scu-pnt/receiver-v0/max2769test.csv

Reference | Qty | Value | DNP | Exclude from BOM | Exclude from Board | Footprint | Datasheet
C1,C2 | 2 | .47n |  |  |  | Capacitor_SMD:C_0402_1005Metric
C3 | 1 | 27p |  |  |  | Capacitor_SMD:C_0603_1608Metric
C4 | 1 | .47n |  |  |  | Capacitor_SMD:C_0603_1608Metric
C6,C7,C8,C9,C28,C29,C51,C52,C62,C63 | 10 | 1u |  |  |  | Capacitor_SMD:C_0603_1608Metric
C10,C12,C14,C16,C18 | 5 | 100p |  |  |  | Capacitor_SMD:C_0402_1005Metric
C11,C13,C15,C17,C19,C31,C33,C35,C37,C39,C42,C44,C46,C48,C50,C54,C56,C66 | 18 | 100n |  |  |  | Capacitor_SMD:C_0402_1005Metric
C20,C22,C57,C64 | 4 | 100p |  |  |  | Capacitor_SMD:C_0603_1608Metric
C21,C23,C26,C61 | 4 | 100n |  |  |  | Capacitor_SMD:C_0603_1608Metric
C24 | 1 | .01u |  |  |  | Capacitor_SMD:C_0402_1005Metric
C25,C60 | 2 | 4.7u |  |  |  | Capacitor_SMD:C_0603_1608Metric
C27 | 1 | .1u |  |  |  | Capacitor_SMD:C_0603_1608Metric
C30,C32,C34,C36,C38,C41,C43,C53,C55,C65 | 10 | 4.7u |  |  |  | Capacitor_SMD:C_0402_1005Metric
C40 | 1 | 1u |  |  |  | Capacitor_SMD:C_0402_1005Metric
C58,C59 | 2 | 27p |  |  |  | Capacitor_SMD:C_0402_1005Metric
D1,D2,D3 | 3 | LED |  |  |  | LED_SMD:LED_0805_2012Metric
J1 | 1 | Conn_Coaxial |  |  |  | Connector_Coaxial:SMA_Samtec_SMA-J-P-H-ST-EM1_EdgeMount
J2 | 1 | RJ45_JK0654219 |  |  |  | Connector_RJ:RJ45_Pulse_JK0654219NL_Horizontal | https://media.digikey.com/pdf/Data%20Sheets/Pulse%20PDFs/JK%20Series.pdf
J3 | 1 | Conn_01x03_Socket |  |  |  | Connector_JST:JST_SH_SM03B-SRSS-TB_1x03-1MP_P1.00mm_Horizontal
J4 | 1 | Conn_01x05_Pin |  |  |  | Connector_PinHeader_2.54mm:PinHeader_1x05_P2.54mm_Vertical
J5 | 1 | USB_C_Receptacle_PowerOnly_6P |  |  |  | Connector_USB:USB_C_Receptacle_GCT_USB4125-xx-x_6P_TopMnt_Horizontal | https://www.usb.org/sites/default/files/documents/usb_type-c.zip
J6 | 1 | Conn_02x02_Odd_Even |  |  |  | Connector_PinHeader_2.54mm:PinHeader_2x02_P2.54mm_Vertical
JP3 | 1 | Jumper_2_Open |  |  |  | Connector_PinHeader_2.54mm:PinHeader_1x02_P2.54mm_Vertical
R1 | 1 | 20k |  |  |  | Resistor_SMD:R_0603_1608Metric
R2 | 1 | 22 |  |  |  | Resistor_SMD:R_0603_1608Metric
R3 | 1 | 100 |  |  |  | Resistor_SMD:R_0402_1005Metric
R4,R5,R6,R8,R10,R12,R32,R33,R34,R35,R36,R37,R38,R42 | 14 | 4.7k |  |  |  | Resistor_SMD:R_0603_1608Metric
R7 | 1 | 1.5k |  |  |  | Resistor_SMD:R_0603_1608Metric
R9,R11,R13 | 3 | 510 |  |  |  | Resistor_SMD:R_0603_1608Metric
R14,R15,R16,R17,R18,R19,R20,R21,R22,R23,R24,R25,R26,R27,R29,R30,R45 | 17 | 22 |  |  |  | Resistor_SMD:R_0402_1005Metric
R31 | 1 | 2.49k 1% |  |  |  | Resistor_SMD:R_0603_1608Metric
R39,R40,R41 | 3 | 10k |  |  |  | Resistor_SMD:R_0603_1608Metric
R43,R44 | 2 | 5.1k |  |  |  | Resistor_SMD:R_0603_1608Metric
SW1 | 1 | SW_Push |  |  |  | Button_Switch_THT:SW_PUSH_6mm
TP1,TP2,TP3,TP4,TP5,TP6,TP7,TP8,TP9,TP10,TP11,TP12,TP13,TP14,TP15,TP16,TP17,TP18,TP19,TP20,TP21,TP22,TP23,TP24,TP26,TP27,TP28,TP29,TP30,TP31,TP32,TP33,TP34,TP35 | 34 | TestPoint |  |  |  | TestPoint:TestPoint_Pad_D1.0mm
U1 | 1 | MAX2769B |  |  |  | Package_DFN_QFN:TQFN-28-1EP_5x5mm_P0.5mm_EP3.25x3.25mm_ThermalVias
U2 | 1 | ICE40UP5K-SG48ITR |  |  |  | Package_DFN_QFN:QFN-48-1EP_7x7mm_P0.5mm_EP5.6x5.6mm_ThermalVias | http://www.latticesemi.com/Products/FPGAandCPLD/iCE40Ultra
U3 | 1 | STM32C051K6T6 |  |  |  | Package_QFP:LQFP-32_7x7mm_P0.8mm | https://www.st.com/resource/en/datasheet/stm32c051c6.pdf
U4,U5,U7,U9 | 4 | TPS7A20 |  |  |  | Package_TO_SOT_SMD:SOT-23-5
U6 | 1 | TX22-M010S |  |  |  | Crystal:Crystal_SMD_WE_CFPX-218-4Pin_2.5x2.0mm
U8 | 1 | RTL8211FD |  |  |  | Package_DFN_QFN:QFN-40-1EP_5x5mm_P0.4mm_EP3.6x3.6mm_ThermalVias
U10,U11 | 2 | TPS22918 |  |  |  | Package_TO_SOT_SMD:SOT-23-6
U12 | 1 | BY25Q16AW |  |  |  | Package_SO:SOIC-8_3.9x4.9mm_P1.27mm
Y1 | 1 | TSX-3225 |  |  |  | Crystal:Crystal_SMD_3225-4Pin_3.2x2.5mm
