scu-pnt/receiver-v0/max2769test.kicad_pcb

## KiCad design max2769test.kicad_pcb (2026-11-08)

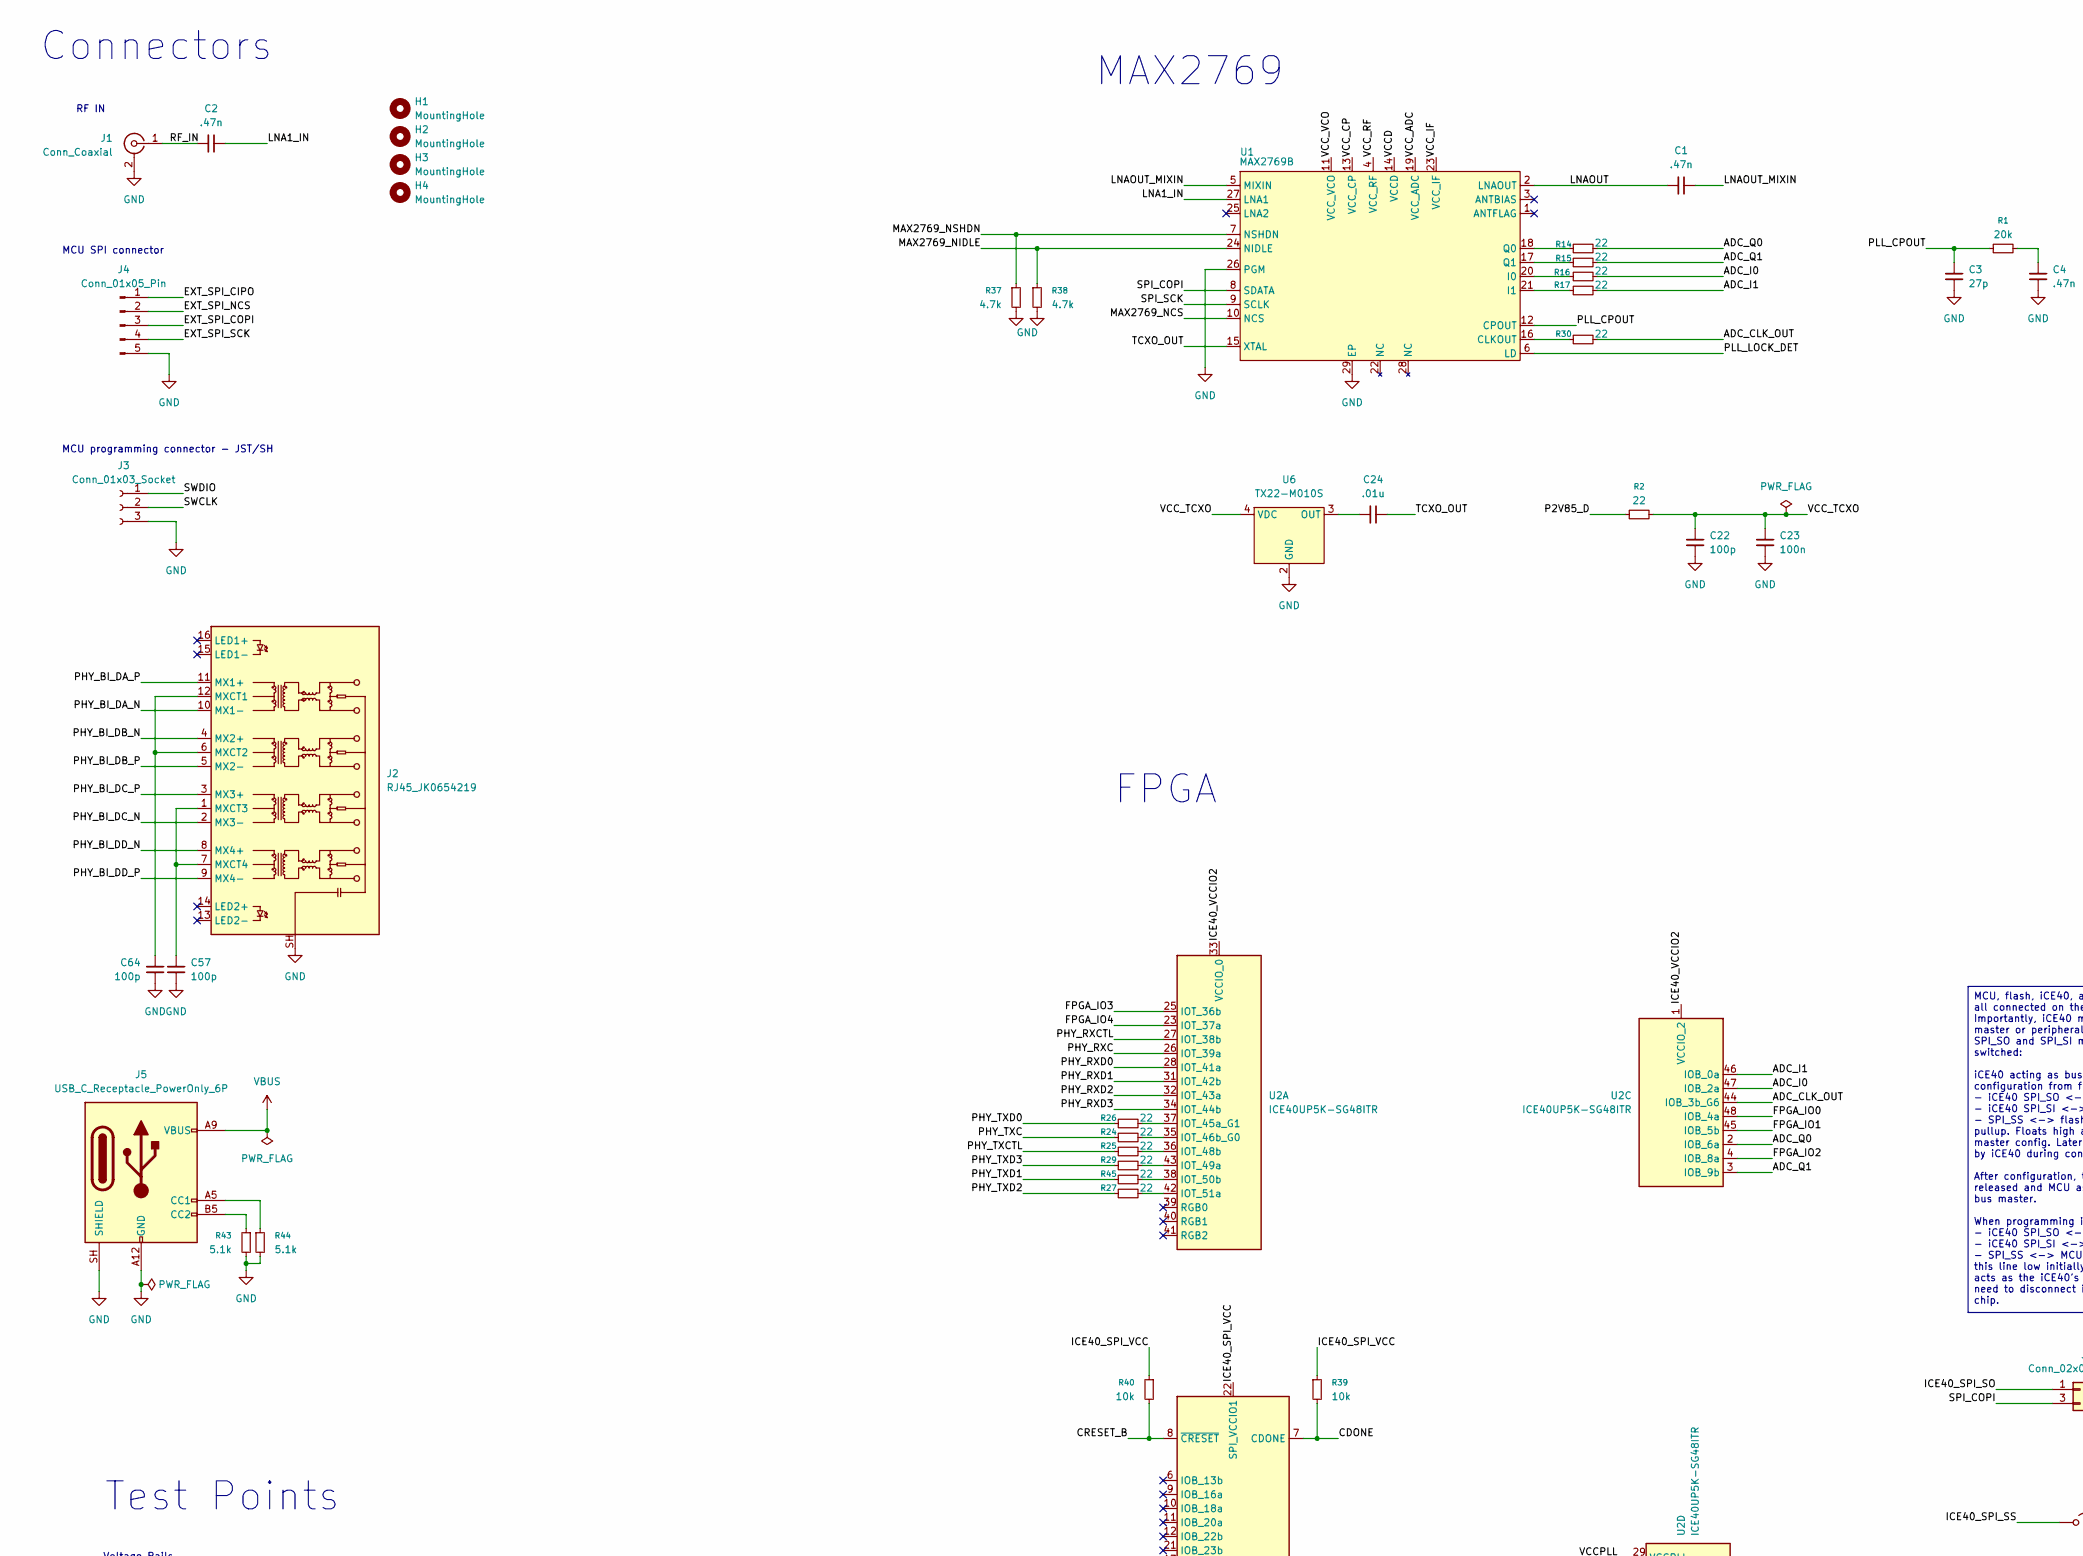
[picture p1: schematic max2769test.kicad_sch, Receiver V0, part in row 1, column 1]

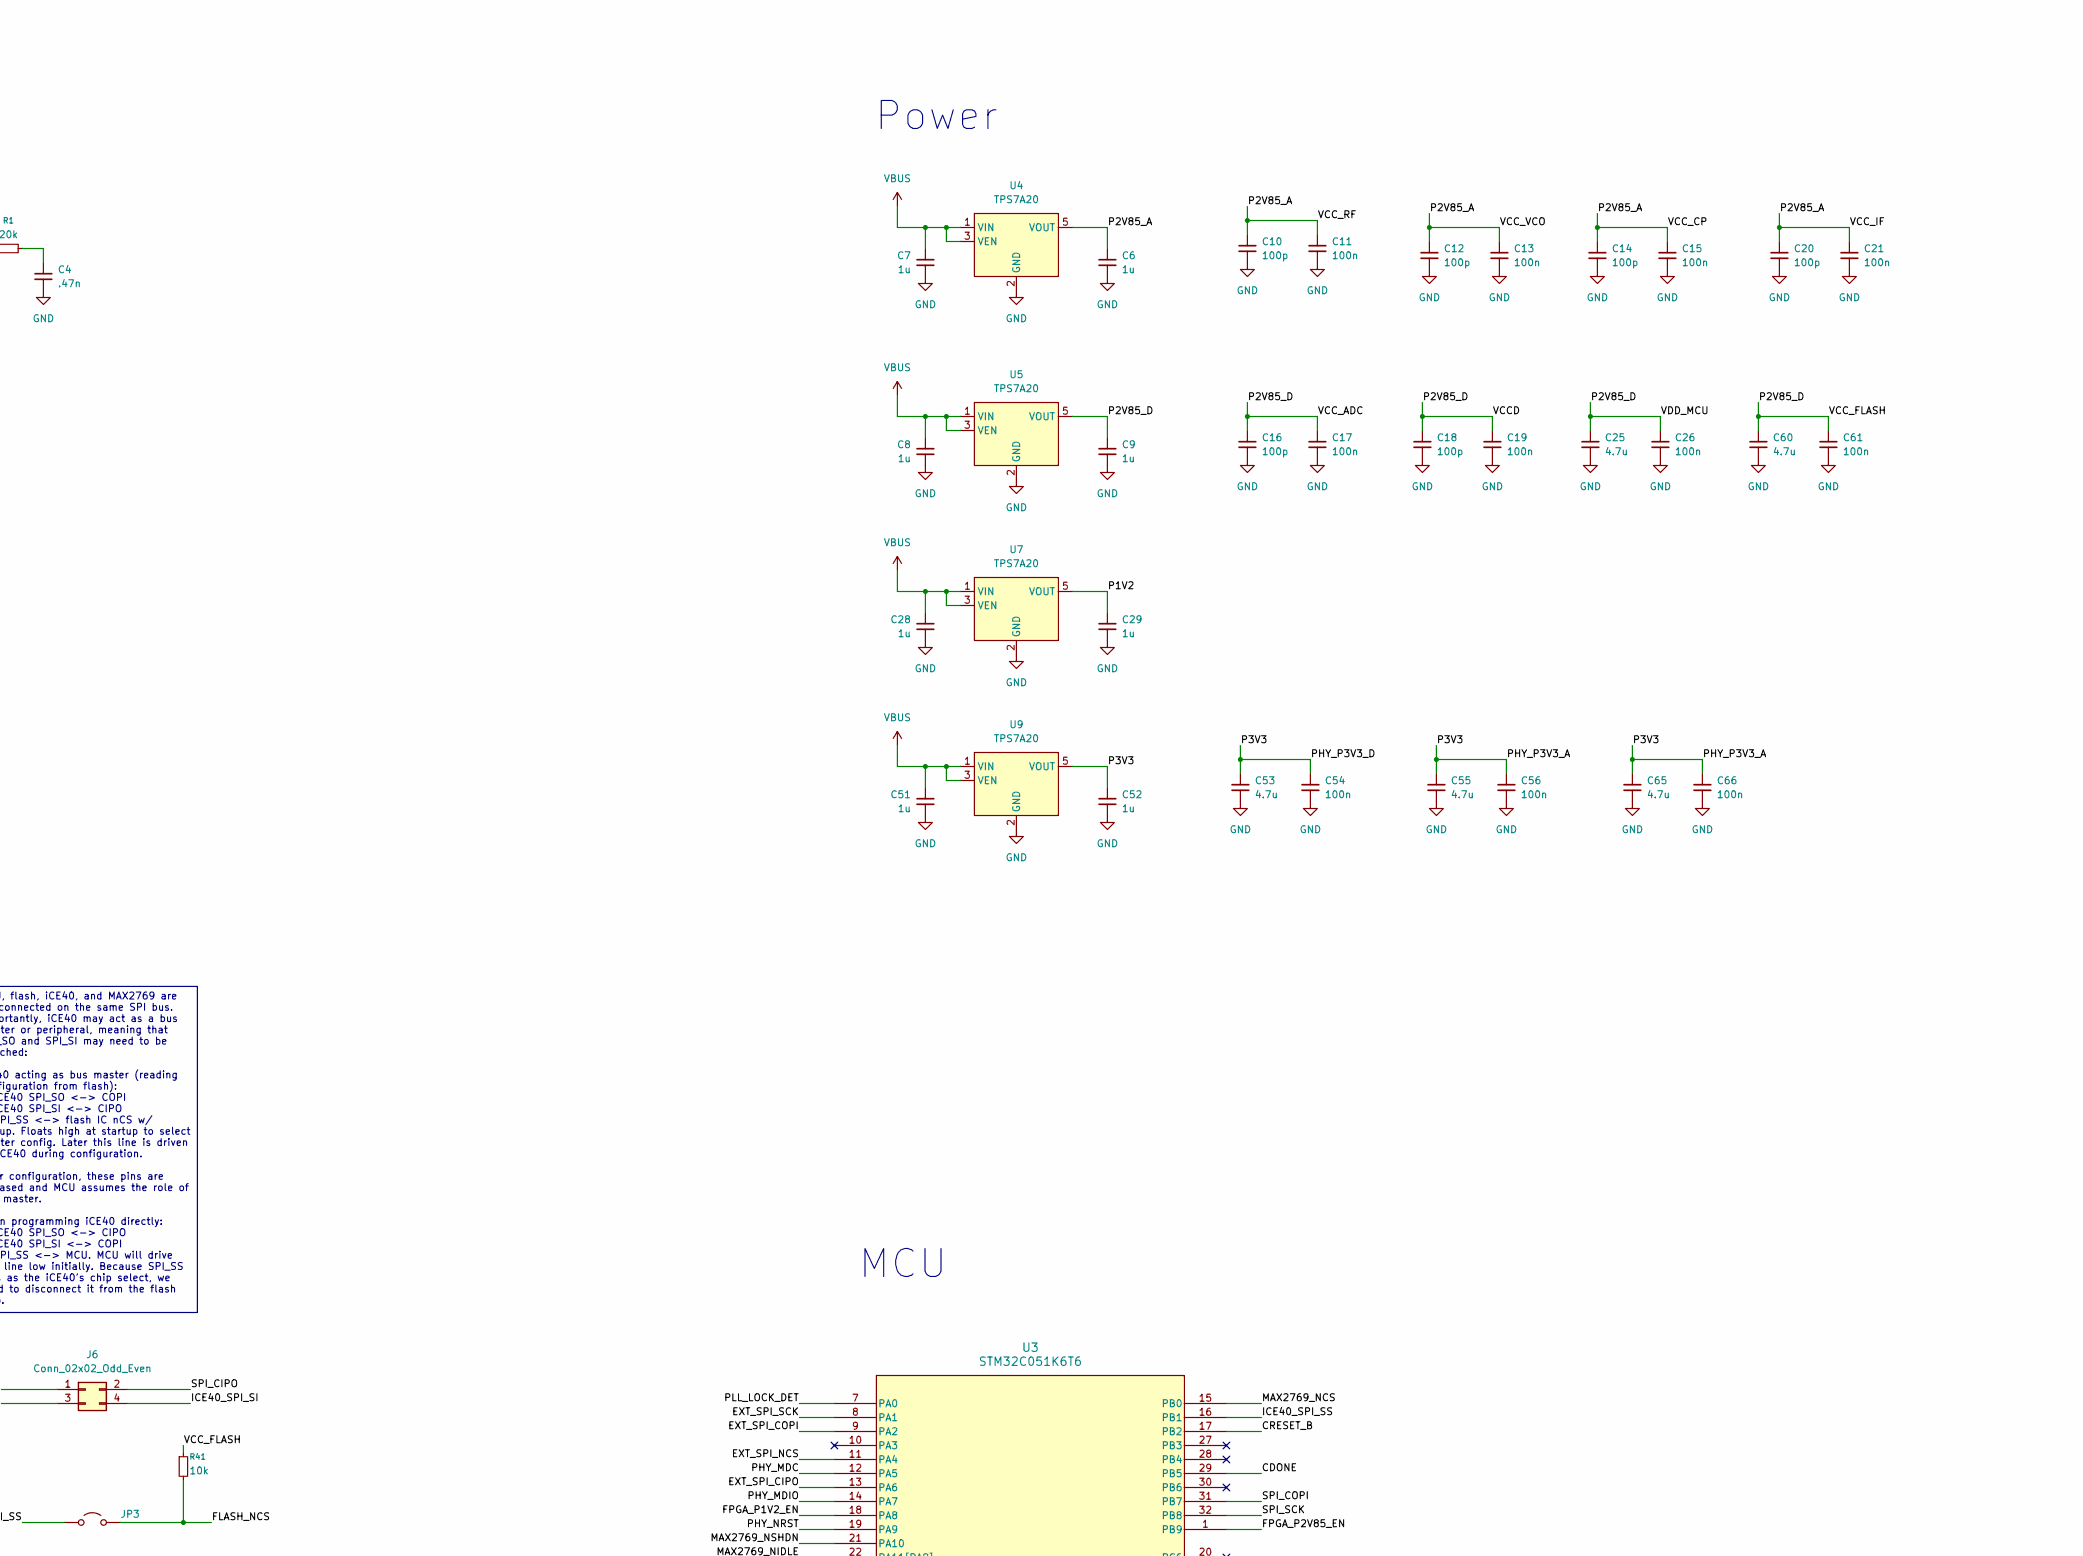
[picture p2: schematic max2769test.kicad_sch, Receiver V0, part in row 1, column 2]

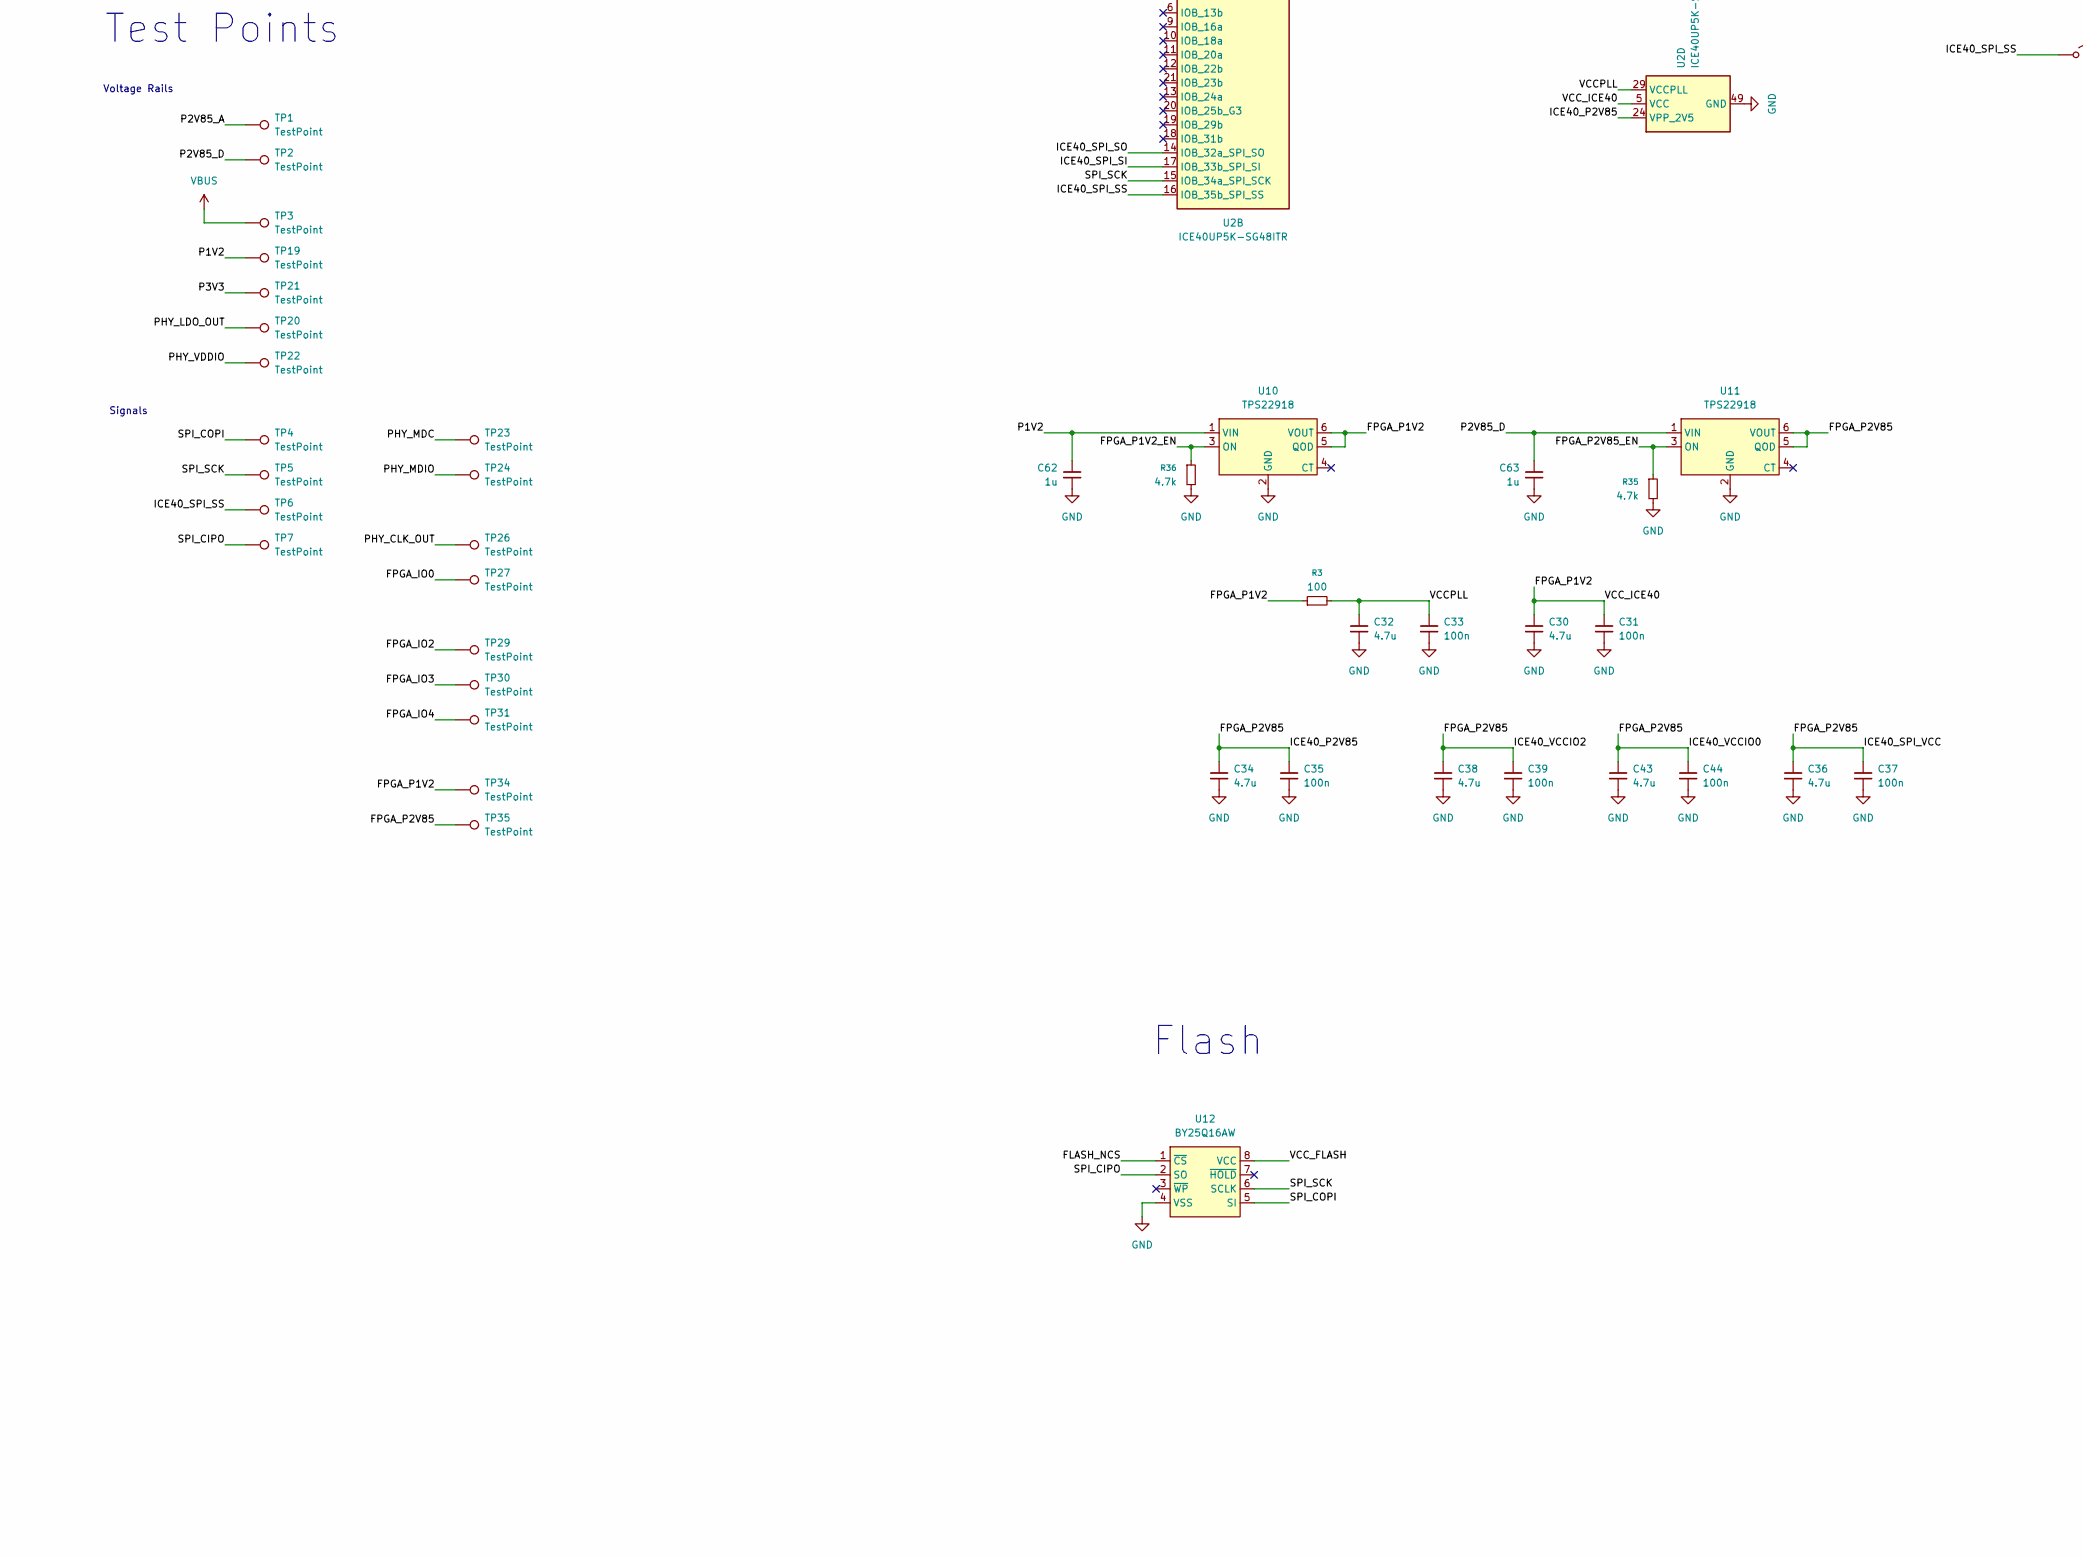
[picture p3: schematic max2769test.kicad_sch, Receiver V0, part in row 2, column 1]

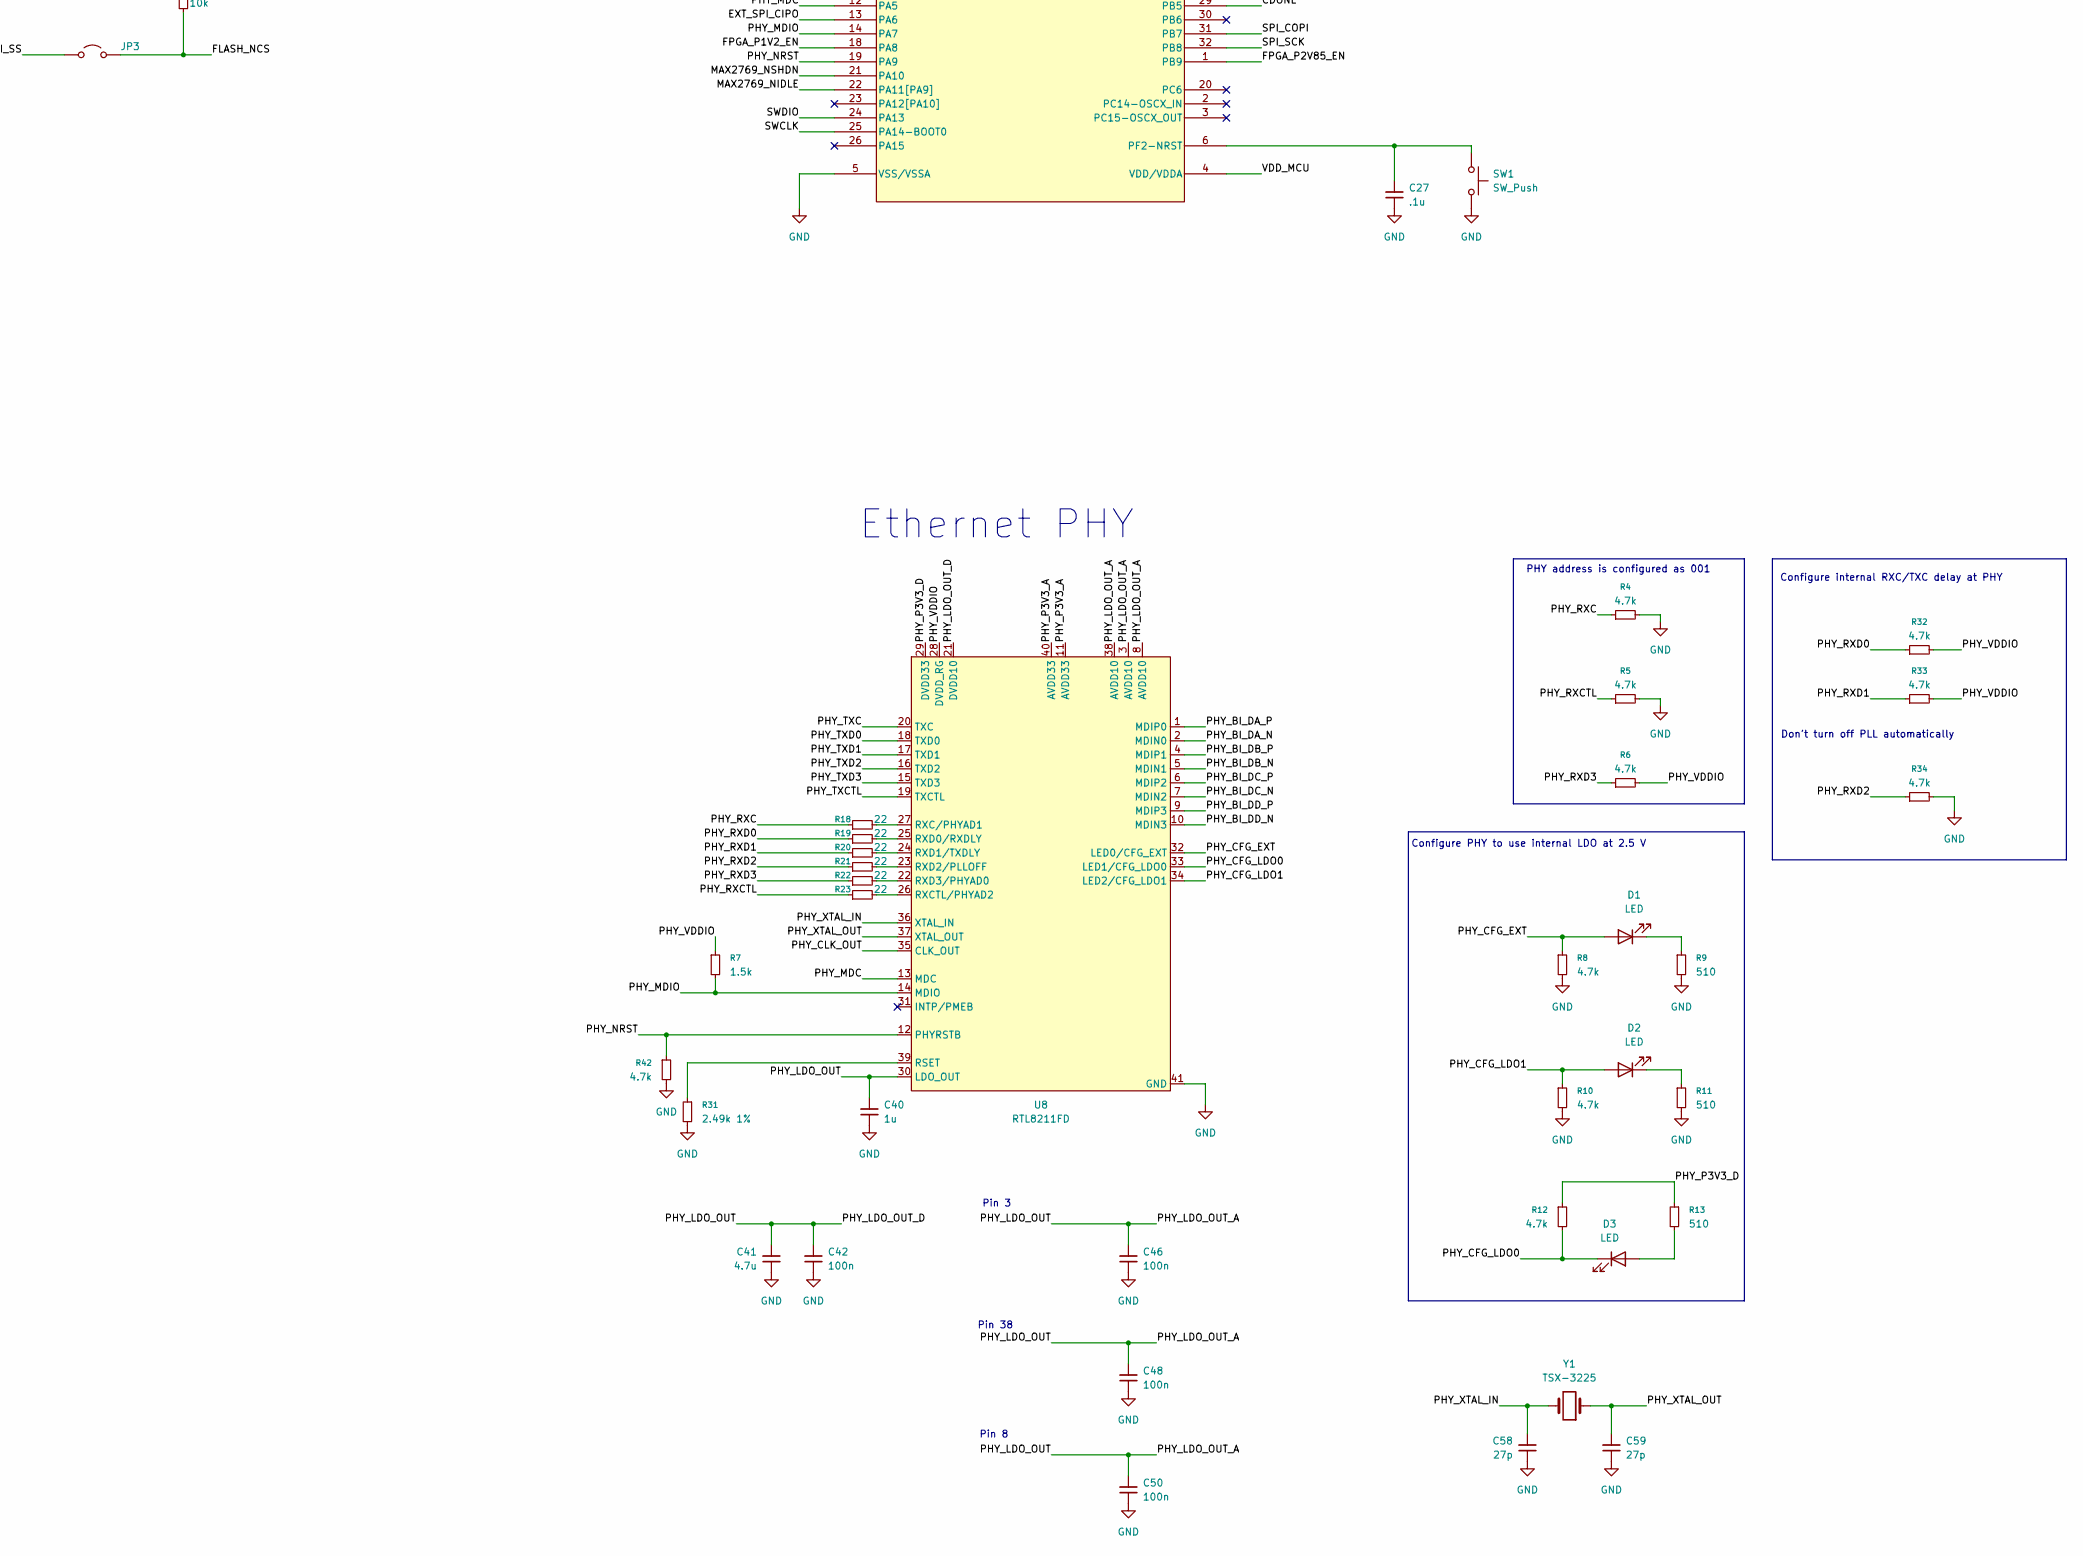
[picture p4: schematic max2769test.kicad_sch, Receiver V0, part in row 2, column 2]

Parts:
C1, C2, C4: .47n; C_0402_1005Metric
C3, C58, C59: 27p; C_0402_1005Metric
C6, C7, C8, C9, C28, C29, C51, C52, C62, C63: 1u; C_0603_1608Metric
C10, C12, C14, C16, C18: 100p; C_0402_1005Metric
C11, C13, C15, C17, C19, C31, C33, C35, C37, C39, C42, C44, C46, C48, C50, C54, C56, C66: 100n; C_0402_1005Metric
C20, C22, C57, C64: 100p; C_0603_1608Metric
C21, C23, C26, C61: 100n; C_0603_1608Metric
C24: .01u; C_0402_1005Metric
C25, C60: 4.7u; C_0603_1608Metric
C27: .1u; C_0603_1608Metric
C30, C32, C34, C36, C38, C41, C43, C53, C55, C65: 4.7u; C_0402_1005Metric
C40: 1u; C_0402_1005Metric
D1, D2, D3: LED; LED_0805_2012Metric
H1, H2, H3, H4: MountingHole; MountingHole_3.2mm_M3
J1: Conn_Coaxial; SMA_Samtec_SMA-J-P-H-ST-EM1_EdgeMount
J2: RJ45_JK0654219; RJ45_Pulse_JK0654219NL_Horizontal
J3: Conn_01x03_Socket; JST_SH_SM03B-SRSS-TB_1x03-1MP_P1.00mm_Horizontal
J4: Conn_01x05_Pin; PinHeader_1x05_P2.54mm_Vertical
J5: USB_C_Receptacle_PowerOnly_6P; USB_C_Receptacle_GCT_USB4125-xx-x_6P_TopMnt_Horizontal
J6: Conn_02x02_Odd_Even; PinHeader_2x02_P2.54mm_Vertical
JP3: Jumper_2_Open; PinHeader_1x02_P2.54mm_Vertical
R1: 20k; R_0402_1005Metric
R2: 22; R_0603_1608Metric
R3: 100; R_0402_1005Metric
R4, R8, R10, R12, R35, R36, R37, R38, R42: 4.7k; R_0603_1608Metric
R5, R6, R32, R33, R34: 4.7k; R_0402_1005Metric
R7: 1.5k; R_0603_1608Metric
R9, R11, R13: 510; R_0603_1608Metric
R14, R15, R16, R17, R18, R19, R20, R21, R22, R23, R24, R25, R26, R27, R29, R30, R45: 22; R_0402_1005Metric
R31: 2.49k 1%; R_0603_1608Metric
R39, R40, R41: 10k; R_0603_1608Metric
R43, R44: 5.1k; R_0603_1608Metric
SW1: SW_Push; SW_PUSH_6mm
TP1, TP2, TP3, TP4, TP5, TP6, TP7, TP19, TP20, TP21, TP22, TP23, TP24, TP26, TP27, TP29, TP30, TP31, TP34, TP35: TestPoint; TestPoint_Pad_D1.0mm
U1: MAX2769B; TQFN-28-1EP_5x5mm_P0.5mm_EP3.25x3.25mm_ThermalVias
U2: ICE40UP5K-SG48ITR; QFN-48-1EP_7x7mm_P0.5mm_EP5.6x5.6mm_ThermalVias
U3: STM32C051K6T6; LQFP-32_7x7mm_P0.8mm
U4, U5, U7, U9: TPS7A20; SOT-23-5
U6: TX22-M010S; Crystal_SMD_WE_CFPX-218-4Pin_2.5x2.0mm
U8: RTL8211FD; QFN-40-1EP_5x5mm_P0.4mm_EP3.6x3.6mm_ThermalVias
U10, U11: TPS22918; SOT-23-6
U12: BY25Q16AW; SOIC-8_3.9x4.9mm_P1.27mm
Y1: TSX-3225; Crystal_SMD_3225-4Pin_3.2x2.5mm

Connections:
/ADC_CLK_OUT: R30.2, U2.44 (IOB_3b_G6)
/ADC_I0: R16.2, U2.47 (IOB_2a)
/ADC_I1: R17.2, U2.46 (IOB_0a)
/ADC_Q0: R14.2, U2.2 (IOB_6a)
/ADC_Q1: R15.2, U2.3 (IOB_9b)
/CDONE: R39.2, U2.7 (CDONE), U3.29 (PB5)
/CRESET_B: R40.2, U2.8 (~CRESET), U3.17 (PB2)
/EXT_SPI_CIPO: J4.1, U3.13 (PA6)
/EXT_SPI_COPI: J4.3, U3.9 (PA2)
/EXT_SPI_NCS: J4.2, U3.11 (PA4)
/EXT_SPI_SCK: J4.4, U3.8 (PA1)
/FLASH_NCS: JP3.2 (B), R41.2, U12.1 (~CS)
/FPGA_IO0: TP27.1 (1_1), U2.48 (IOB_4a)
/FPGA_IO1: U2.45 (IOB_5b)
/FPGA_IO2: TP29.1 (1_1), U2.4 (IOB_8a)
/FPGA_IO3: TP30.1 (1_1), U2.25 (IOT_36b)
/FPGA_IO4: TP31.1 (1_1), U2.23 (IOT_37a)
/FPGA_P1V2: C30.1, C31.1, R3.1, TP34.1 (1_1), U2.5 (VCC), U2.30 (VCC), U10.5 (QOD), U10.6 (VOUT)
/FPGA_P1V2_EN: R36.1, U3.18 (PA8), U10.3 (ON)
/FPGA_P2V85: C34.1, C35.1, C36.1, C37.1, C38.1, C39.1, C43.1, C44.1, R39.1, R40.1, TP35.1 (1_1), U2.1 (VCCIO_2), U2.22 (SPI_VCCIO1), U2.24 (VPP_2V5), U2.33 (VCCIO_0), U11.5 (QOD), U11.6 (VOUT)
/FPGA_P2V85_EN: R35.1, U3.1 (PB9), U11.3 (ON)
/ICE40_SPI_SI: J6.4, U2.17 (IOB_33b_SPI_SI)
/ICE40_SPI_SO: J6.1, U2.14 (IOB_32a_SPI_SO)
/ICE40_SPI_SS: JP3.1 (A), TP6.1 (1_1), U2.16 (IOB_35b_SPI_SS), U3.16 (PB1)
/LNA1_IN: C2.2, U1.27 (LNA1)
/LNAOUT: C1.1, U1.2 (LNAOUT)
/LNAOUT_MIXIN: C1.2, U1.5 (MIXIN)
/MAX2769_NCS: U1.10 (NCS), U3.15 (PB0)
/MAX2769_NIDLE: R38.1, U1.24 (NIDLE), U3.22 (PA11[PA9])
/MAX2769_NSHDN: R37.1, U1.7 (NSHDN), U3.21 (PA10)
/P1V2: C29.1, C62.1, TP19.1 (1_1), U7.5 (VOUT), U10.1 (VIN)
/P2V85_A: C6.1, C10.1, C11.1, C12.1, C13.1, C14.1, C15.1, C20.1, C21.1, TP1.1 (1_1), U1.4 (VCC_RF), U1.11 (VCC_VCO), U1.13 (VCC_CP), U1.23 (VCC_IF), U4.5 (VOUT)
/P2V85_D: C9.1, C16.1, C17.1, C18.1, C19.1, C25.1, C26.1, C60.1, C61.1, C63.1, R2.1, R41.1, TP2.1 (1_1), U1.14 (VCCD), U1.19 (VCC_ADC), U3.4 (VDD/VDDA), U5.5 (VOUT), U11.1 (VIN), U12.8 (VCC)
/P3V3: C52.1, C53.1, C54.1, C55.1, C56.1, C65.1, C66.1, R12.1, R13.1, TP21.1 (1_1), U8.11 (AVDD33), U8.29 (DVDD33), U8.40 (AVDD33), U9.5 (VOUT)
/PHY_BI_DA_N: J2.10 (MX1-), U8.2 (MDIN0)
/PHY_BI_DA_P: J2.11 (MX1+), U8.1 (MDIP0)
/PHY_BI_DB_N: J2.4 (MX2+), U8.5 (MDIN1)
/PHY_BI_DB_P: J2.5 (MX2-), U8.4 (MDIP1)
/PHY_BI_DC_N: J2.2 (MX3-), U8.7 (MDIN2)
/PHY_BI_DC_P: J2.3 (MX3+), U8.6 (MDIP2)
/PHY_BI_DD_N: J2.8 (MX4+), U8.10 (MDIN3)
/PHY_BI_DD_P: J2.9 (MX4-), U8.9 (MDIP3)
/PHY_CFG_EXT: D1.2 (A), R8.1, U8.32 (LED0/CFG_EXT)
/PHY_CFG_LDO0: D3.1 (K), R12.2, U8.33 (LED1/CFG_LDO0)
/PHY_CFG_LDO1: D2.2 (A), R10.1, U8.34 (LED2/CFG_LDO1)
/PHY_CLK_OUT: TP26.1 (1_1), U8.35 (CLK_OUT)
/PHY_LDO_OUT: C40.1, C41.1, C42.1, C46.1, C48.1, C50.1, TP20.1 (1_1), U8.3 (AVDD10), U8.8 (AVDD10), U8.21 (DVDD10), U8.30 (LDO_OUT), U8.38 (AVDD10)
/PHY_MDC: TP23.1 (1_1), U3.12 (PA5), U8.13 (MDC)
/PHY_MDIO: R7.2, TP24.1 (1_1), U3.14 (PA7), U8.14 (MDIO)
/PHY_NRST: R42.1, U3.19 (PA9), U8.12 (PHYRSTB)
/PHY_RXC: R4.1, R18.1, U2.26 (IOT_39a)
/PHY_RXCTL: R5.1, R23.1, U2.27 (IOT_38b)
/PHY_RXD0: R19.1, R32.1, U2.28 (IOT_41a)
/PHY_RXD1: R20.1, R33.1, U2.31 (IOT_42b)
/PHY_RXD2: R21.1, R34.1, U2.32 (IOT_43a)
/PHY_RXD3: R6.1, R22.1, U2.34 (IOT_44b)
/PHY_TXC: R24.1, U8.20 (TXC)
/PHY_TXCTL: R25.1, U8.19 (TXCTL)
/PHY_TXD0: R26.1, U8.18 (TXD0)
/PHY_TXD1: R45.1, U8.17 (TXD1)
/PHY_TXD2: R27.1, U8.16 (TXD2)
/PHY_TXD3: R29.1, U8.15 (TXD3)
/PHY_VDDIO: R6.2, R7.1, R32.2, R33.2, TP22.1 (1_1), U8.28 (DVDD_RG)
/PHY_XTAL_IN: C58.1, U8.36 (XTAL_IN), Y1.2
/PHY_XTAL_OUT: C59.1, U8.37 (XTAL_OUT), Y1.1
/PLL_CPOUT: C3.1, R1.1, U1.12 (CPOUT)
/PLL_LOCK_DET: U1.6 (LD), U3.7 (PA0)
/RF_IN: C2.1, J1.1 (In)
/SPI_CIPO: J6.2, TP7.1 (1_1), U12.2 (SO)
/SPI_COPI: J6.3, TP4.1 (1_1), U1.8 (SDATA), U3.31 (PB7), U12.5 (SI)
/SPI_SCK: TP5.1 (1_1), U1.9 (SCLK), U2.15 (IOB_34a_SPI_SCK), U3.32 (PB8), U12.6 (SCLK)
/SWCLK: J3.2, U3.25 (PA14-BOOT0)
/SWDIO: J3.1, U3.24 (PA13)
/TCXO_OUT: C24.2, U1.15 (XTAL)
/VCCPLL: C32.1, C33.1, R3.2, U2.29 (VCCPLL)
/VCC_TCXO: C22.1, C23.1, R2.2, U6.4 (VDC)
GND: C3.2, C4.2, C6.2, C7.2, C8.2, C9.2, C10.2, C11.2, C12.2, C13.2, C14.2, C15.2, C16.2, C17.2, C18.2, C19.2, C20.2, C21.2, C22.2, C23.2, C25.2, C26.2, C27.2, C28.2, C29.2, C30.2, C31.2, C32.2, C33.2, C34.2, C35.2, C36.2, C37.2, C38.2, C39.2, C40.2, C41.2, C42.2, C43.2, C44.2, C46.2, C48.2, C50.2, C51.2, C52.2, C53.2, C54.2, C55.2, C56.2, C57.2, C58.2, C59.2, C60.2, C61.2, C62.2, C63.2, C64.2, C65.2, C66.2, J1.2 (Ext), J2.SH, J3.3, J4.5, J5.A12 (GND), J5.B12 (GND), J5.SH (SHIELD), R4.2, R5.2, R8.2, R9.2, R10.2, R11.2, R31.2, R34.2, R35.2, R36.2, R37.2, R38.2, R42.2, R43.2, R44.2, SW1.2, U1.26 (PGM), U1.29 (EP), U2.49 (GND), U3.5 (VSS/VSSA), U4.2 (GND), U5.2 (GND), U6.2 (GND), U7.2 (GND), U8.41 (GND), U9.2 (GND), U10.2 (GND), U11.2 (GND), U12.4 (VSS)
unnamed: C4.1, R1.2
unnamed: D1.1 (K), R9.1
unnamed: D2.1 (K), R11.1
unnamed: D3.2 (A), R13.2
unnamed: C64.1, J2.6 (MXCT2), J2.12 (MXCT1)
unnamed: C57.1, J2.1 (MXCT3), J2.7 (MXCT4)
unnamed: J5.A5 (CC1), R44.1
unnamed: J5.B5 (CC2), R43.1
unnamed: R30.1, U1.16 (CLKOUT)
unnamed: R16.1, U1.20 (I0)
unnamed: R17.1, U1.21 (I1)
unnamed: R14.1, U1.18 (Q0)
unnamed: R15.1, U1.17 (Q1)
unnamed: R26.2, U2.37 (IOT_45a_G1)
unnamed: R24.2, U2.35 (IOT_46b_G0)
unnamed: R25.2, U2.36 (IOT_48b)
unnamed: R29.2, U2.43 (IOT_49a)
unnamed: R45.2, U2.38 (IOT_50b)
unnamed: R27.2, U2.42 (IOT_51a)
unnamed: C27.1, SW1.1, U3.6 (PF2-NRST)
unnamed: C24.1, U6.3 (OUT)
unnamed: R31.1, U8.39 (RSET)
unnamed: R23.2, U8.26 (RXCTL/PHYAD2)
unnamed: R18.2, U8.27 (RXC/PHYAD1)
unnamed: R19.2, U8.25 (RXD0/RXDLY)
unnamed: R20.2, U8.24 (RXD1/TXDLY)
unnamed: R21.2, U8.23 (RXD2/PLLOFF)
unnamed: R22.2, U8.22 (RXD3/PHYAD0)
VBUS: C7.1, C8.1, C28.1, C51.1, J5.A9 (VBUS), J5.B9 (VBUS), TP3.1 (1_1), U4.1 (VIN), U4.3 (VEN), U5.1 (VIN), U5.3 (VEN), U7.1 (VIN), U7.3 (VEN), U9.1 (VIN), U9.3 (VEN)

Notes on the sheet:
Don't turn off PLL automatically
MCU programming connector - JST/SH
Configure PHY to use internal LDO at 2.5 V
Ethernet PHY
Configure internal RXC/TXC delay at PHY
Voltage Rails
Pin 3
Connectors
RF IN
PHY address is configured as 001
MCU
Pin 38
Test Points
MCU SPI connector
Pin 8
FPGA
Power
MAX2769
Signals
Flash
MCU, flash, iCE40, and MAX2769 are all connected on the same SPI bus. Importantly, iCE40 may act as a bus master or peripheral, meaning that SPI_SO and SPI_SI may need to be switched: iCE40 acting as bus master (reading configuration from flash): - iCE40 SPI_SO <-> COPI - iCE40 SPI_SI <-> CIPO - SP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

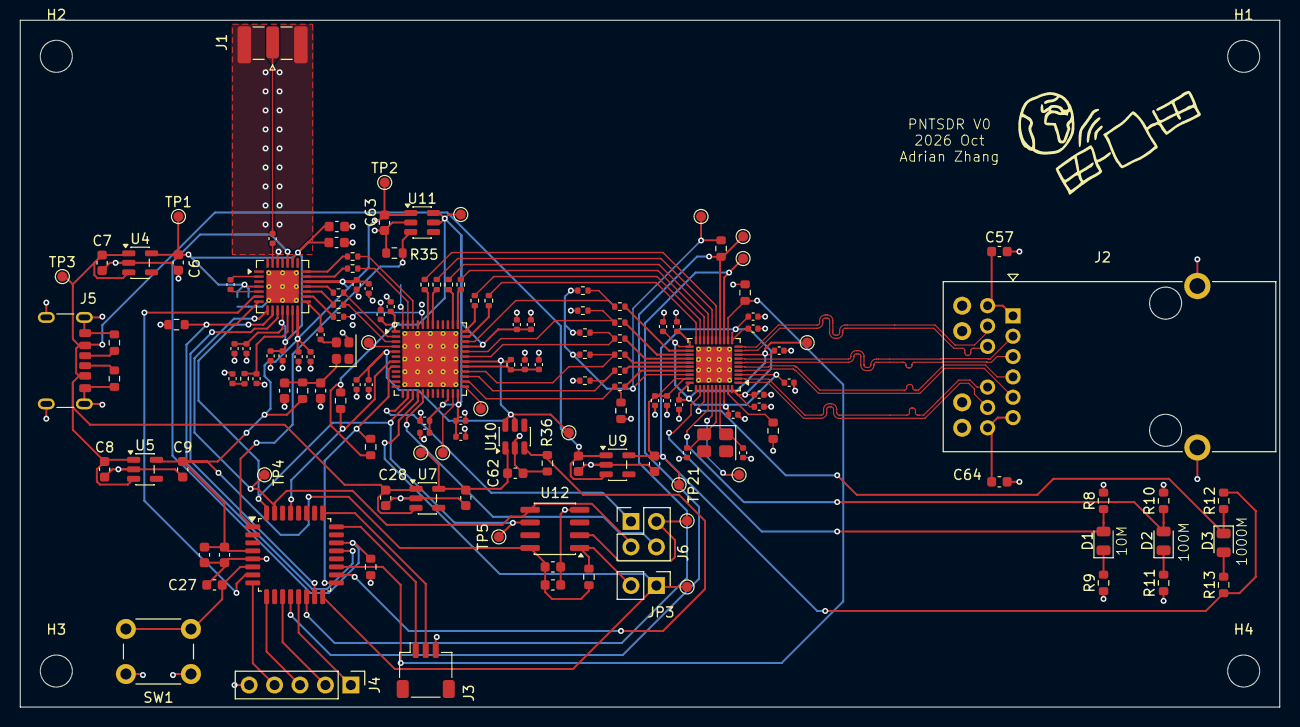
[picture p5: board max2769test.kicad_pcb from above]

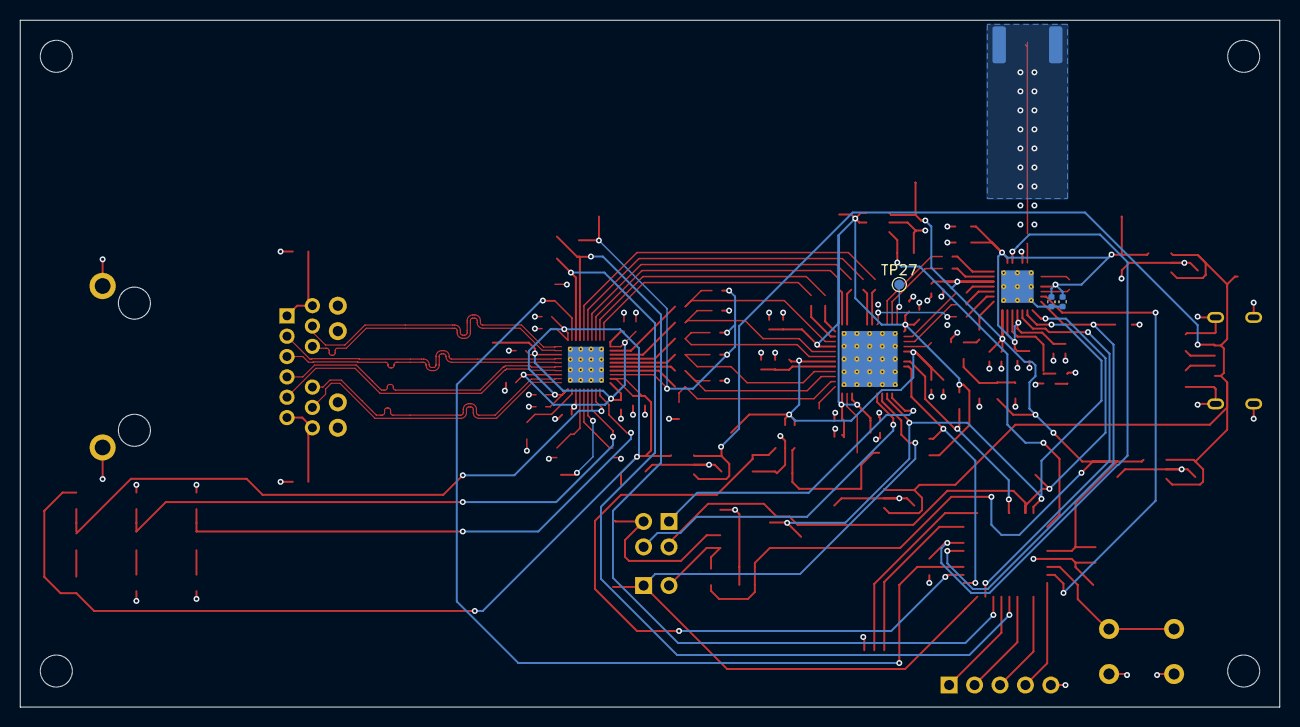
[picture p6: board max2769test.kicad_pcb from below]

Board: 4 copper layers, 125.8 x 68.6 mm, 154 parts (3 on the bottom side), 105 nets.
