scu-pnt/receiver-v0/(commit log)

2026-09-27 work on ethernet phy layout
    [max2769test.kicad_sch]
2026-09-27 add series resistors to digital signals
    [max2769test.kicad_sch]
2026-09-28 mostly finish up PHY schematic
    [max2769test.kicad_sch]
2026-09-29 add pullups
    [max2769test.kicad_sch]
2026-09-29 fix SPI bus oversights w/ jumpers
    [max2769test.kicad_sch]
2026-09-29 add flash
    [max2769test.kicad_sch]
2026-09-29 start assigning footprints
    [max2769test.kicad_sch]
2026-09-30 50 ohm traces
    [max2769test.kicad_sch]
2026-09-30 layout start!
    [max2769test.kicad_pcb, max2769test.kicad_sch]
2026-10-05 work on PHY layout
    [max2769test.kicad_pcb, max2769test.kicad_sch]
2026-10-19 lots of power layout
2026-10-20 mounting holes
